MARS-UVA/Jetson_Extension_Board/LTST_C191KGKT/LTST-C191KGKT.step

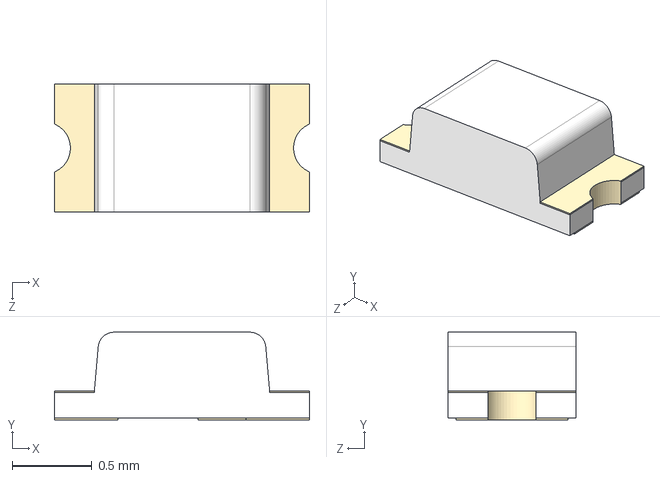
[picture p1: CAD file, 2024-10-27]
LTST_C191KGKT/LTST-C191KGKT.step
1.60 x 0.55 x 0.8 mm
