MARS-UVA/Jetson_Extension_Board/RC0603FR_07150RL/RC0603FR-07150RL.step

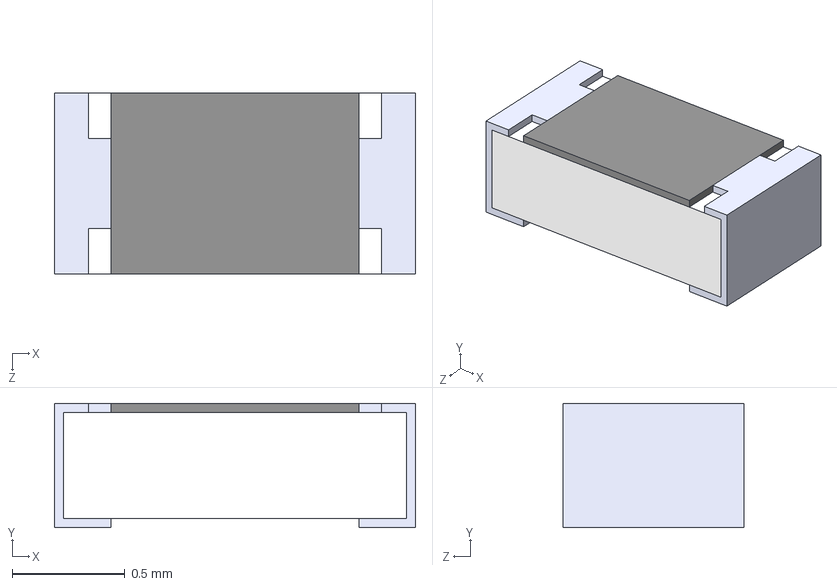
[picture p2: CAD file, 2024-10-27]
RC0603FR_07150RL/RC0603FR-07150RL.step
1.60 x 0.55 x 0.8 mm
