MARS-UVA/Jetson_Extension_Board/Jetson_Extension_Board.kicad_pcb

## KiCad design Jetson_Extension_Board.kicad_pcb (2025-04-29)

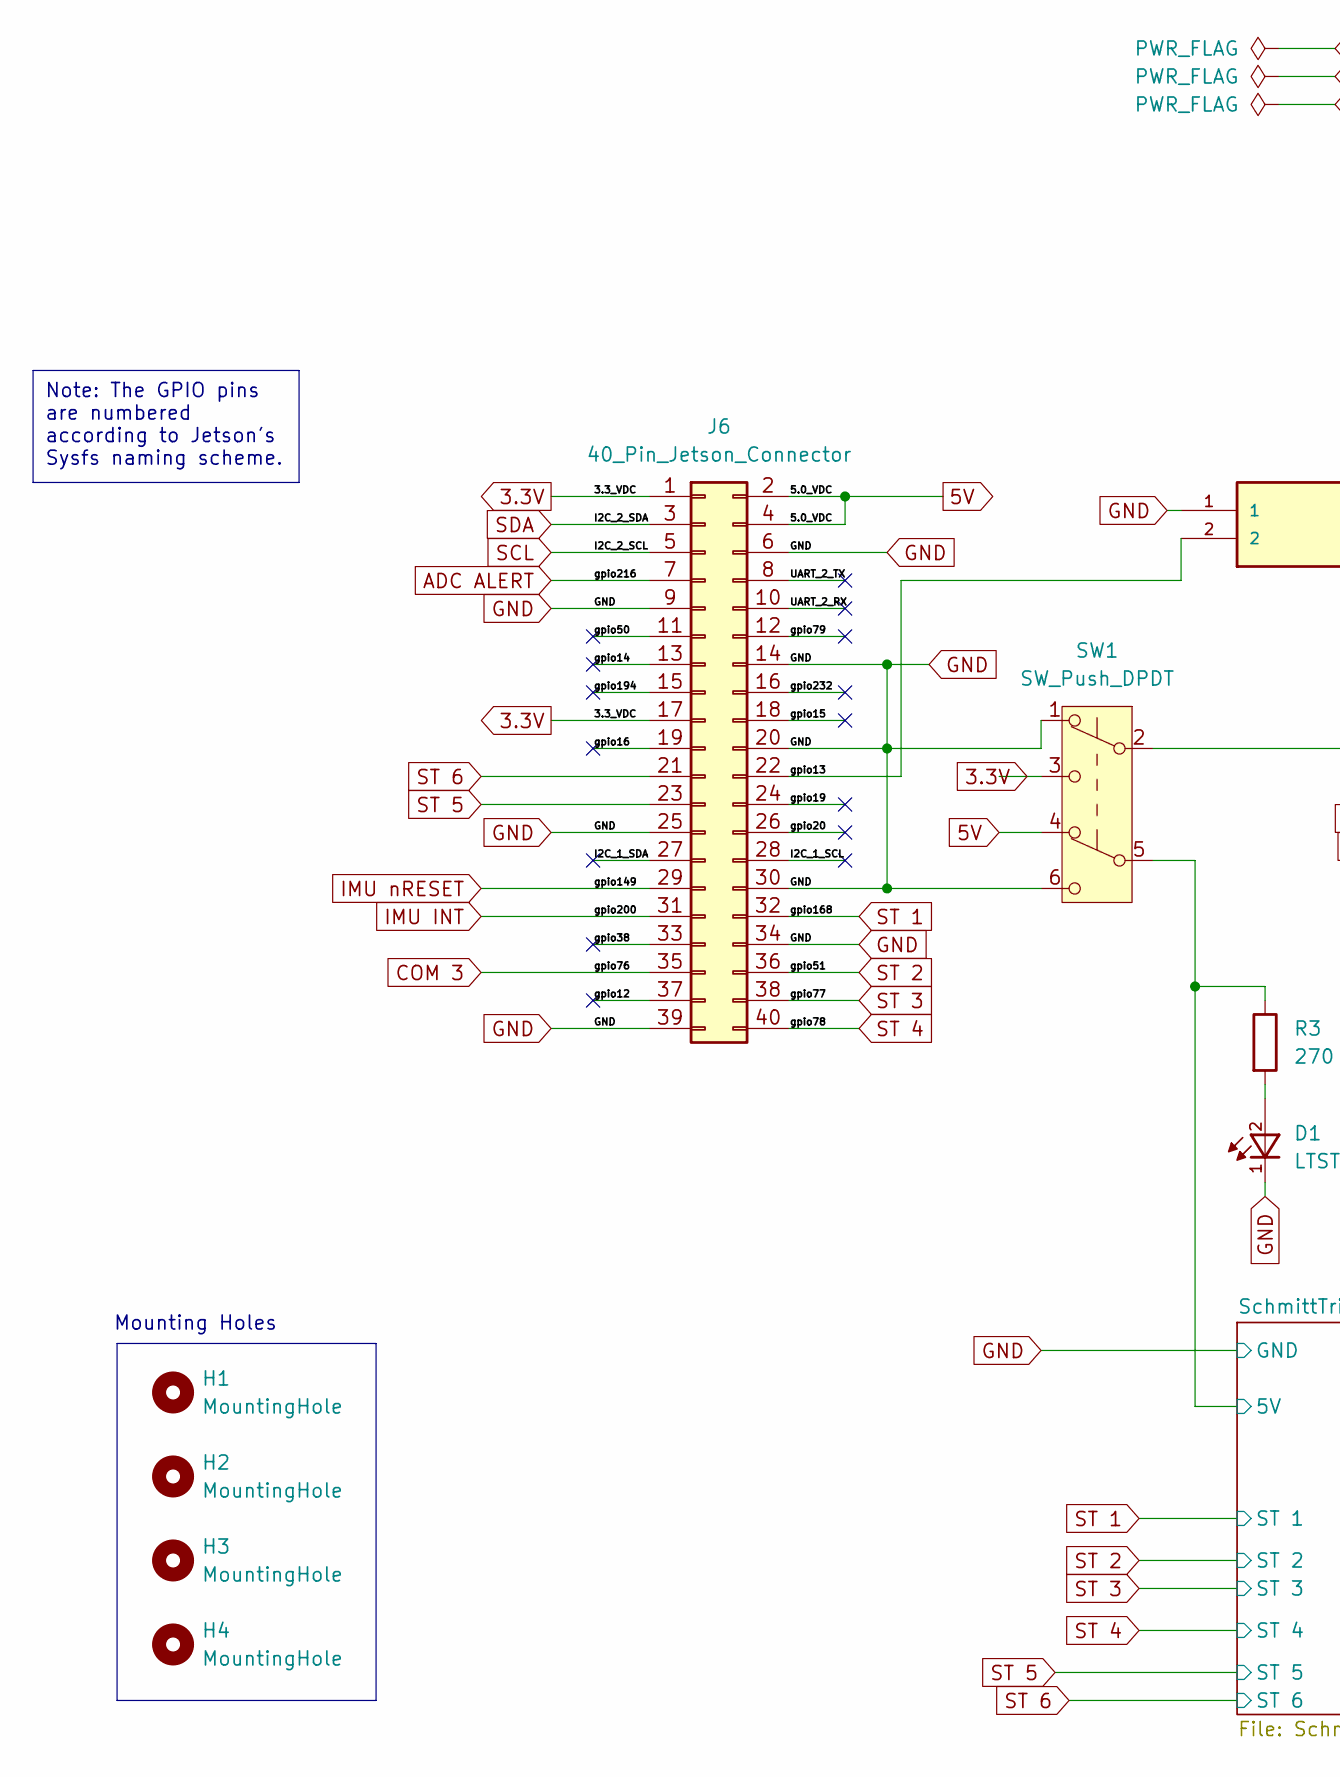
[picture p3: schematic Jetson_Extension_Board.kicad_sch, part in row 1, column 1]

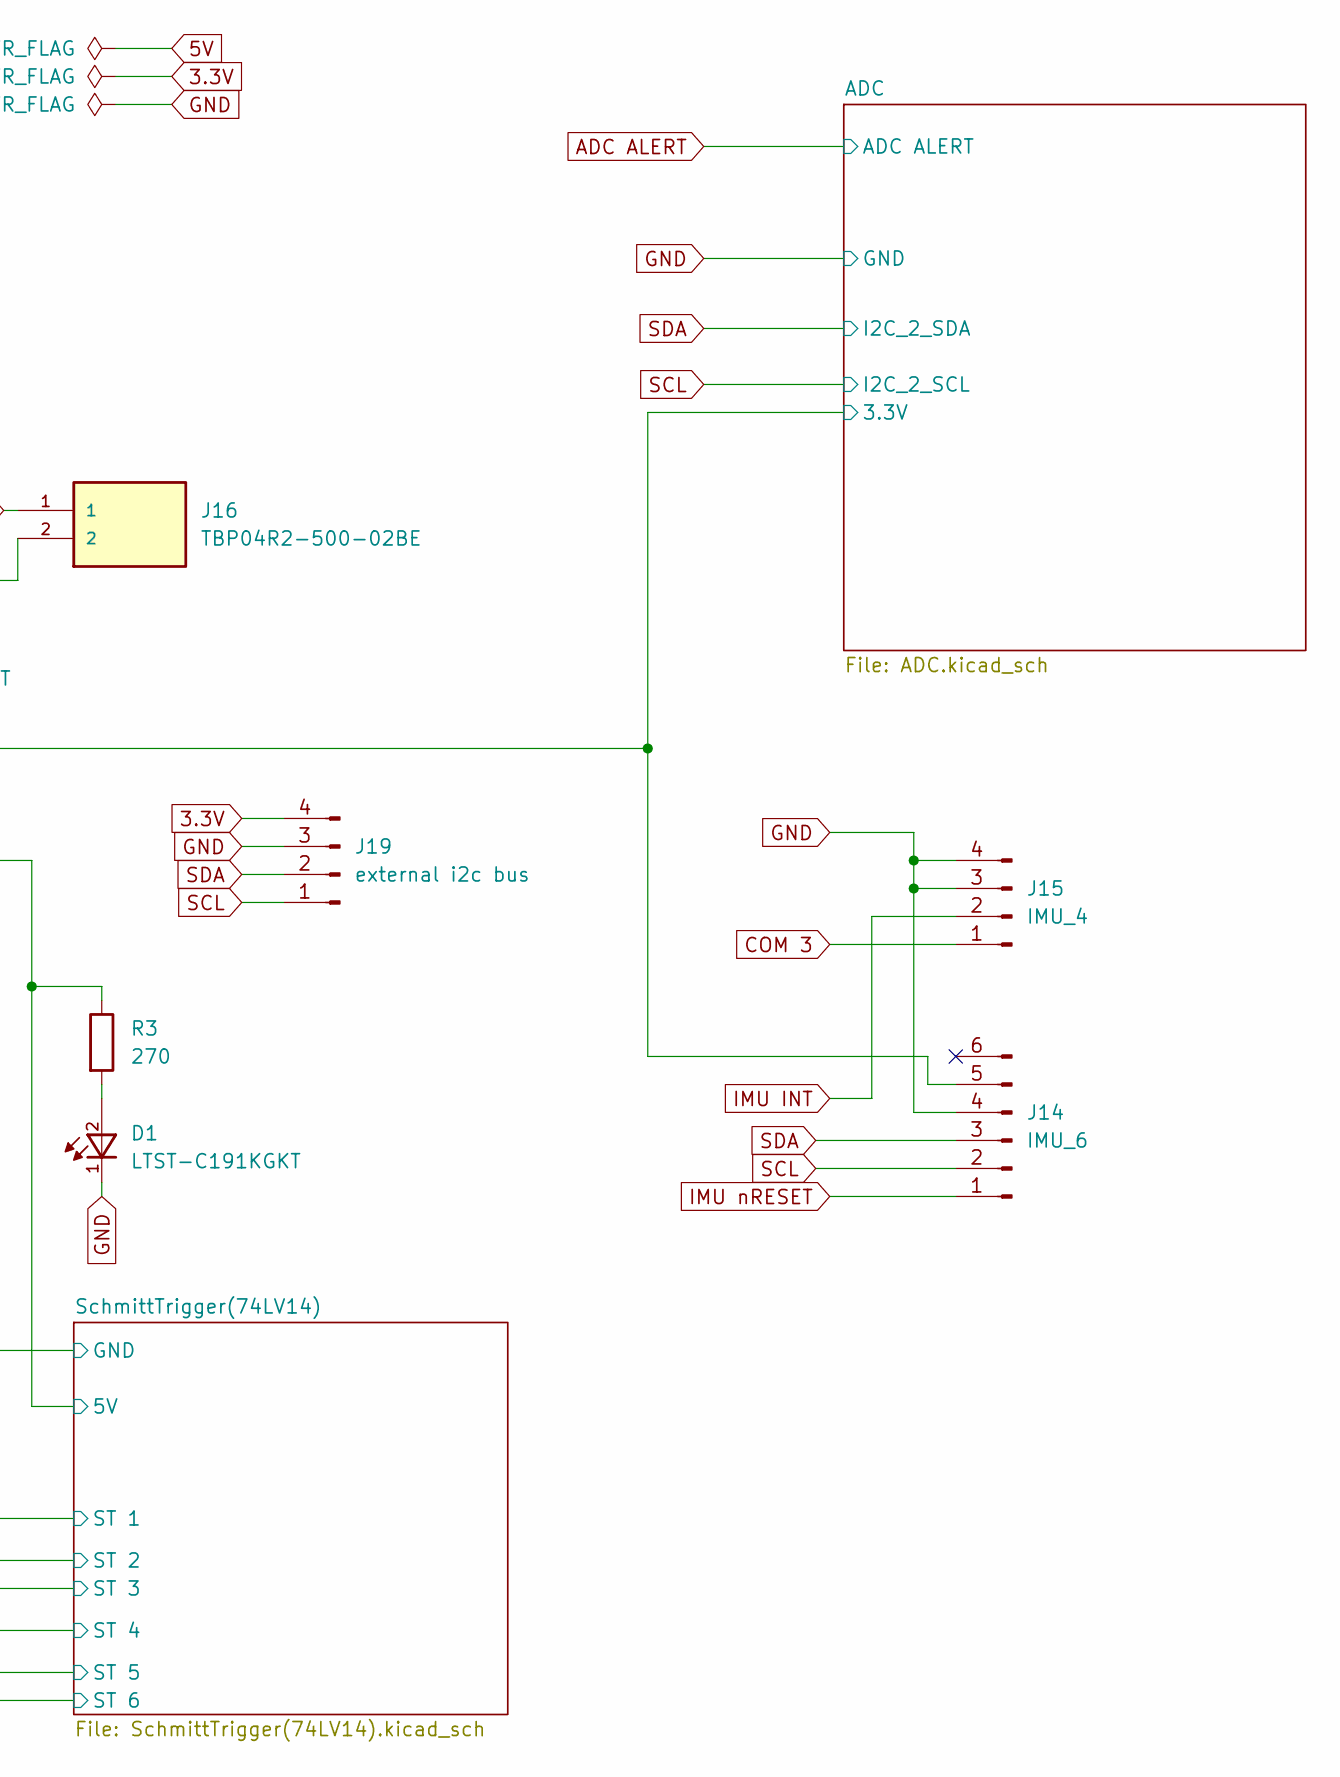
[picture p4: schematic Jetson_Extension_Board.kicad_sch, part in row 1, column 2]

Parts:
D1: LTST-C191KGKT; 0603
H1, H2, H3, H4: MountingHole; MountingHole_2.1mm
J6: 40_Pin_Jetson_Connector; PinHeader_2x20_P2.54mm_Vertical
J14: IMU_6; PinSocket_1x06_P2.54mm_Vertical
J15: IMU_4; PinSocket_1x04_P2.54mm_Vertical
J16: TBP04R2-500-02BE; CUI_TBP04R2-500-02BE; PARTREV 1.0
J19: external i2c bus; TBP04R2-500-04BE
R3: 270; R_1206_3216Metric
SW1: SW_Push_DPDT; SW_CK_JS202011AQN_DPDT_Angled

Connections:
3.3V: J6.1, J6.17, J19.4, SW1.3 (C)
5V: J6.2, J6.4, SW1.4 (A)
/ADC/3.3V: J14.5, SW1.2 (B); also elsewhere on the board
/I2C_1_SCL: J6.28
/I2C_1_SDA: J6.27
/SchmittTrigger(74LV14)/5V: R3.1, SW1.5 (B); also elsewhere on the board
/UART_2_RX: J6.10
/UART_2_TX: J6.8
/gpio12: J6.37
/gpio13: J6.22, J16.2; also elsewhere on the board
/gpio14: J6.13
/gpio15: J6.18
/gpio16: J6.19
/gpio19: J6.24
/gpio20: J6.26
/gpio38: J6.33
/gpio50: J6.11
/gpio79: J6.12
/gpio194: J6.15
/gpio232: J6.16
ADC ALERT: J6.7; also elsewhere on the board
COM 3: J6.35, J15.1
GND: D1.1, J6.6, J6.9, J6.14, J6.20, J6.25, J6.30, J6.34, J6.39, J14.4, J15.3, J15.4, J16.1, J19.3, SW1.1 (A), SW1.6 (C); also elsewhere on the board
IMU INT: J6.31, J15.2
IMU nRESET: J6.29, J14.1
unnamed: D1.2, R3.2
SCL: J6.5, J14.2, J19.1; also elsewhere on the board
SDA: J6.3, J14.3, J19.2; also elsewhere on the board
ST 1: J6.32; also elsewhere on the board
ST 2: J6.36; also elsewhere on the board
ST 3: J6.38; also elsewhere on the board
ST 4: J6.40; also elsewhere on the board
ST 5: J6.23; also elsewhere on the board
ST 6: J6.21; also elsewhere on the board

Notes on the sheet:
Note: The GPIO pins are numbered according to Jetson's Sysfs naming scheme.
Mounting Holes

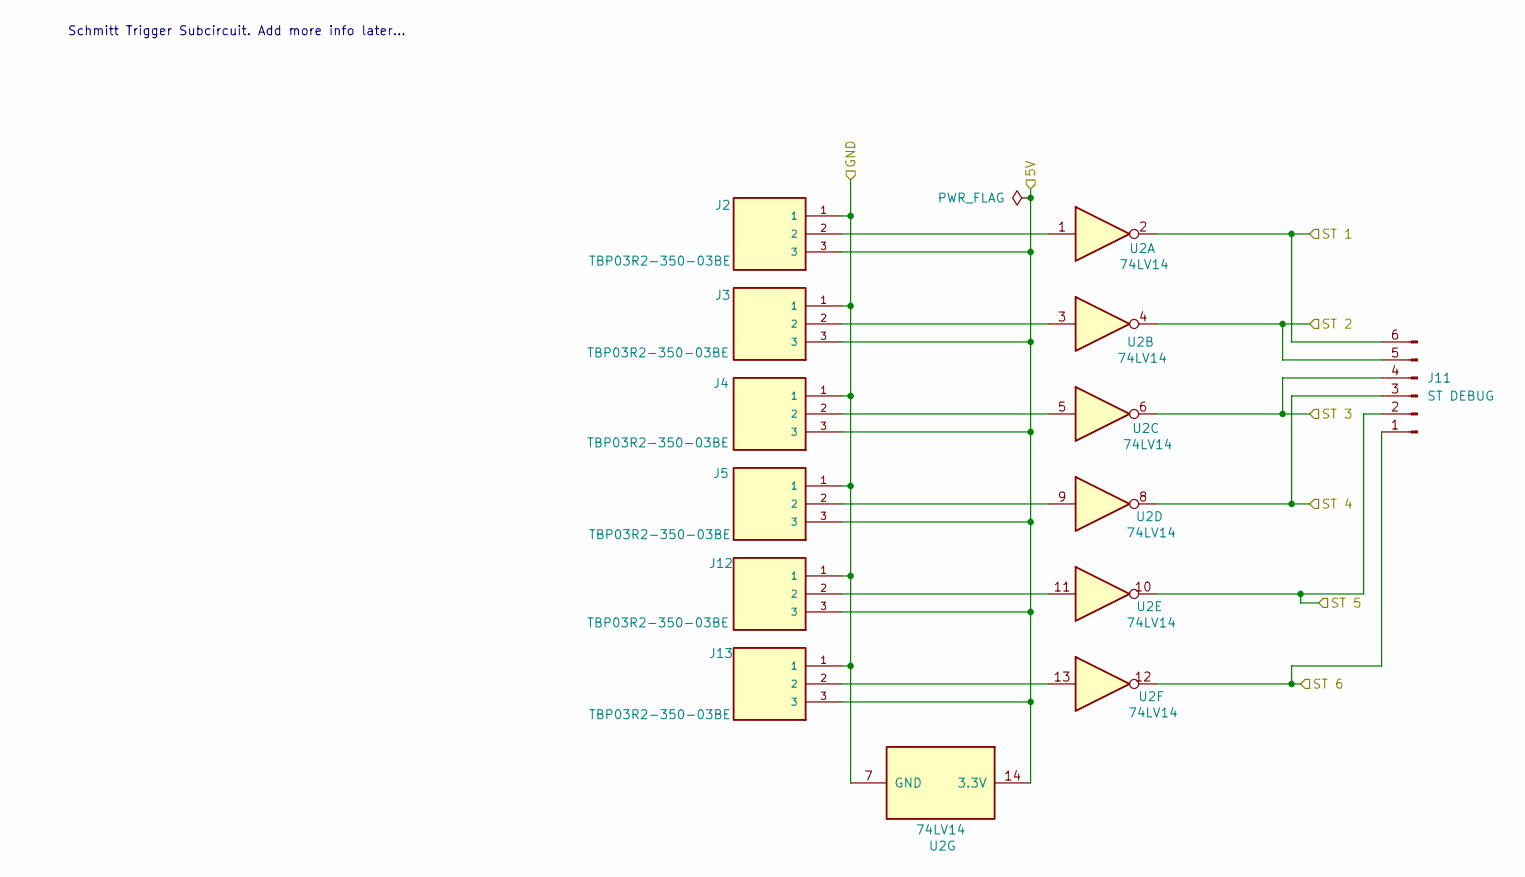
[picture p5: schematic SchmittTrigger(74LV14).kicad_sch]

Parts:
J2, J3, J4, J5, J12, J13: TBP03R2-350-03BE; CUI_TBP03R2-350-03BE; PARTREV 1.0
J11: ST DEBUG; PinSocket_1x06_P2.54mm_Vertical
U2: 74LV14; DIP-14_W7.62mm_Socket

Connections:
/SchmittTrigger(74LV14)/5V: J2.3, J3.3, J4.3, J5.3, J12.3, J13.3, U2.14 (3.3V); also elsewhere on the board
GND: J2.1, J3.1, J4.1, J5.1, J12.1, J13.1, U2.7 (GND); also elsewhere on the board
unnamed: J2.2, U2.1
unnamed: J3.2, U2.3
unnamed: J4.2, U2.5
unnamed: J5.2, U2.9
unnamed: J12.2, U2.11
unnamed: J13.2, U2.13
ST 1: J11.6, U2.2; also elsewhere on the board
ST 2: J11.5, U2.4; also elsewhere on the board
ST 3: J11.4, U2.6; also elsewhere on the board
ST 4: J11.3, U2.8; also elsewhere on the board
ST 5: J11.2, U2.10; also elsewhere on the board
ST 6: J11.1, U2.12; also elsewhere on the board

Notes on the sheet:
Schmitt Trigger Subcircuit. Add more info later...

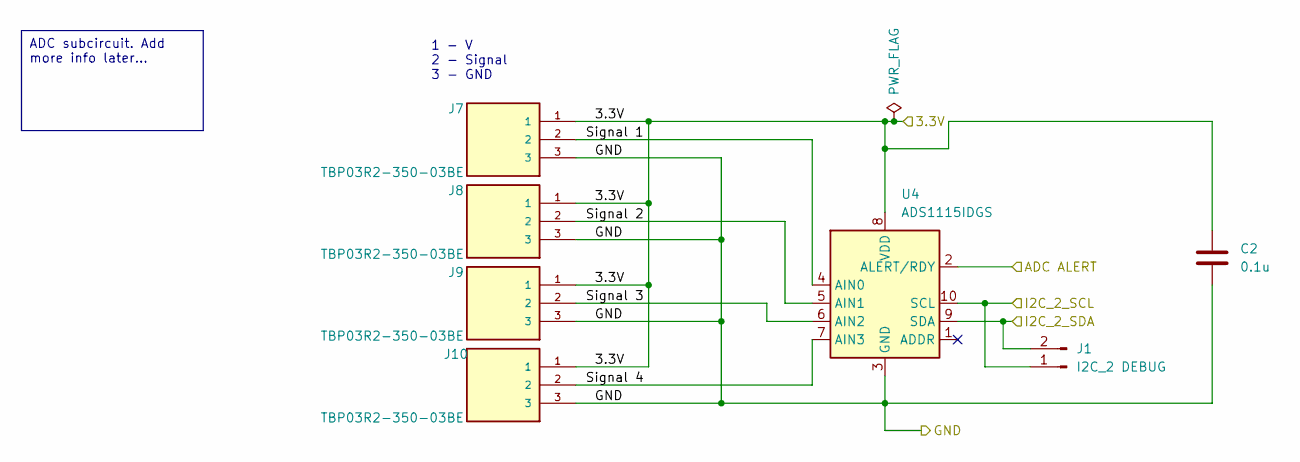
[picture p6: schematic ADC.kicad_sch]

Parts:
C2: 0.1u; C_1206_3216Metric
J1: I2C_2 DEBUG; PinSocket_1x02_P2.54mm_Vertical
J7, J8, J9, J10: TBP03R2-350-03BE; CUI_TBP03R2-350-03BE; PARTREV 1.0
U4: ADS1115IDGS; TSSOP-10_3x3mm_P0.5mm

Connections:
/ADC/3.3V: C2.1, J7.1, J8.1, J9.1, J10.1, U4.8 (VDD); also elsewhere on the board
/ADC/Signal 1: J7.2, U4.4 (AIN0)
/ADC/Signal 2: J8.2, U4.5 (AIN1)
/ADC/Signal 3: J9.2, U4.6 (AIN2)
/ADC/Signal 4: J10.2, U4.7 (AIN3)
ADC ALERT: U4.2 (ALERT/RDY); also elsewhere on the board
GND: C2.2, J7.3, J8.3, J9.3, J10.3, U4.3 (GND); also elsewhere on the board
SCL: J1.1, U4.10 (SCL); also elsewhere on the board
SDA: J1.2, U4.9 (SDA); also elsewhere on the board

Notes on the sheet:
ADC subcircuit. Add more info later...
1 - V 2 - Signal 3 - GND

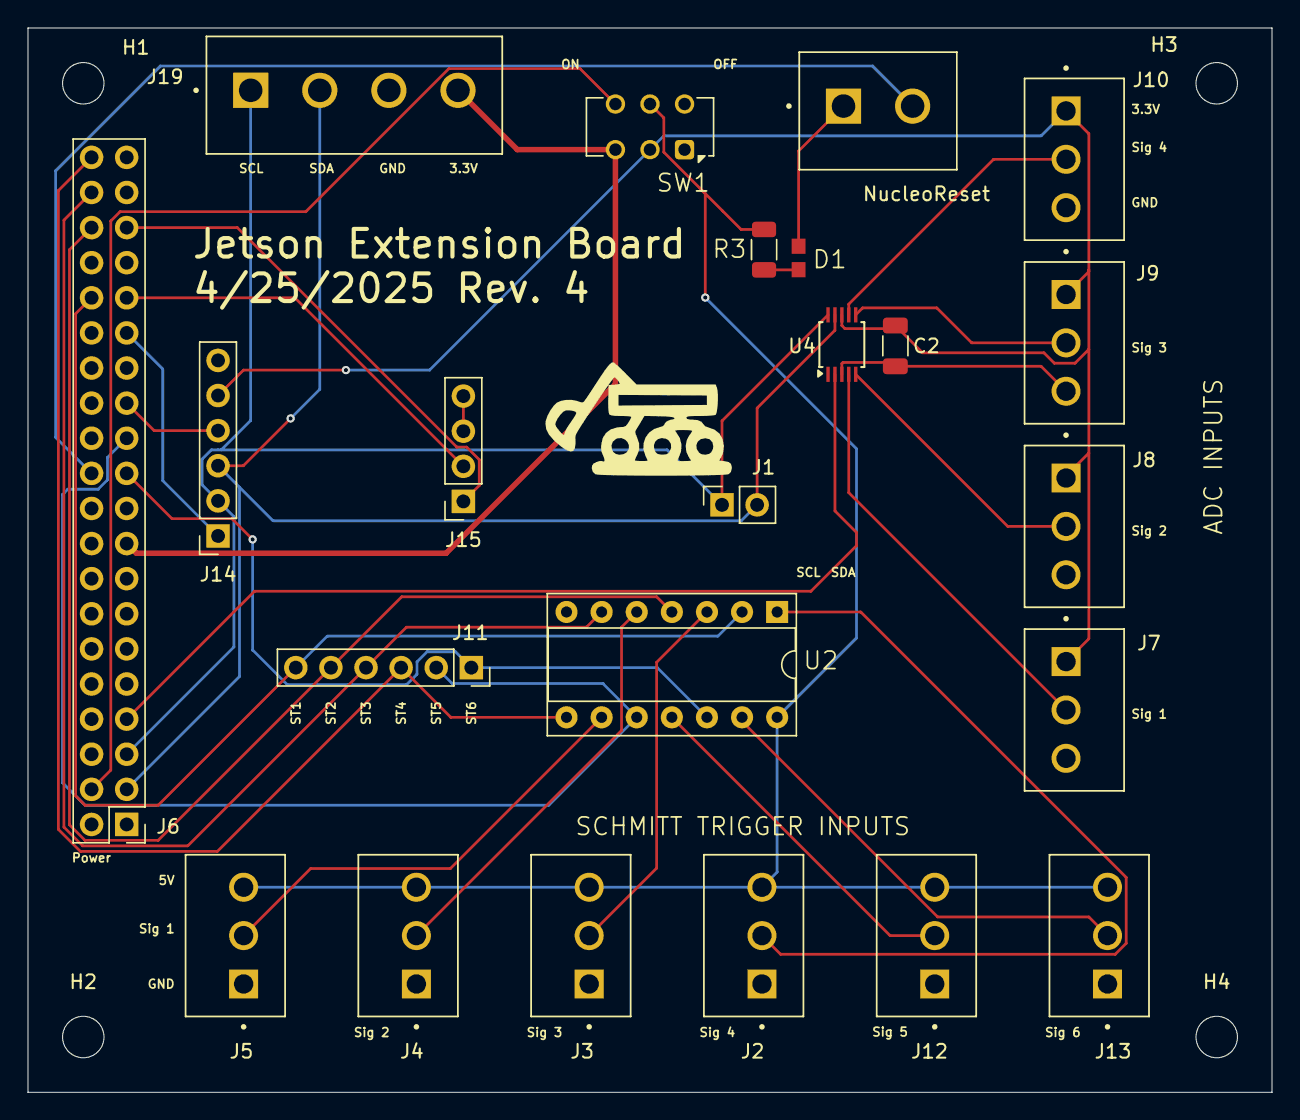
[picture p7: board Jetson_Extension_Board.kicad_pcb from above]

Board: 2 copper layers, 90.0 x 77.0 mm, 27 parts (0 on the bottom side), 29 nets.

Other parts of the board:
NucleoReset: TBP04R2-500-02BE; CUI_TBP04R2-500-02BE

Their connections:
/gpio13: NucleoReset.2; also elsewhere on the board
GND: NucleoReset.1; also elsewhere on the board
