MARS-UVA/Jetson_Extension_Board/(commit log)

2024-10-06 Version 2 of ADS1115 Subcircuit
    Change power voltage to 3.3V and added 100 nF decoupling capacitor
    [Ads1115 subcircuit.kicad_sch]
2024-10-06 Schmitt Trigger Subcircuit
    [Schmitt Trigger Subcircuit.kicad_sch]
2024-10-08 Whole Circuit Integration
    [ADC.kicad_sch, IMU(BN0055).kicad_sch, SchmittTrigger(74LV14).kicad_sch, WholeCircuitIntegration(Flagged).kicad_sch]
2024-10-09 Replaced sockets with terminal blocks
    [ADC.kicad_sch, WholeCircuitIntegration(Flagged).kicad_sch]
2024-10-11 Reorganized schematic and resolved ERC errors
    Resolved some of the ERC errors related to disconnected pins and power flags. Renamed GPIO pins on 40-pin header. Changed ADC power supply to 3.3V and schmitt trigger circuit power supply to 5V. Connected 5V, 3.3V, and GND pins of 40-pin header. Assigned footprint for 40-pin header based on dimensions of expansion header on Jetson Nano Carrier Board.
    Also moved IMU and 40-pin header KiCAD project files into their own folders.
    [ADC.kicad_sch, IMU(BN0055).kicad_sch, IMU_thingy.kicad_sch, SchmittTrigger(74LV14).kicad_sch, WholeCircuitIntegration(Flagged).kicad_sch]
2024-10-11 Renamed the project file to Jetson_Extension_Board
    [Jetson_Extension_Board.kicad_sch]
2024-10-11 Added Layout file
    [Jetson_Extension_Board.kicad_pcb]
2024-10-11 PCB Layout attempted 1
    [Jetson_Extension_Board2.5.1.kicad_pcb, Jetson_Extension_Board2.5.kicad_pcb]
2024-10-18 Worked on PCB Layout
    [Jetson_Extension_Board.kicad_pcb]
2024-10-20 Deleted some extra files
    Deleted Jetson_Extension_Board2.5 and Jetson_Extension_Board2.5.1 Files
    [Jetson_Extension_Board2.5.1.kicad_pcb, Jetson_Extension_Board2.5.kicad_pcb]
2024-10-20 Add debug pins and switch
    [ADC.kicad_sch, Jetson_Extension_Board.kicad_sch, SchmittTrigger(74LV14).kicad_sch]
2024-10-20 Revert "Add debug pins and switch"
    [ADC.kicad_sch, Jetson_Extension_Board.kicad_sch, SchmittTrigger(74LV14).kicad_sch]
2024-10-20 Finished PCB Layout
    [Jetson_Extension_Board.kicad_pcb, Jetson_Extension_Board.kicad_sch]
2024-10-20 Created Gerber and Drill FIles
    [Jetson_Extension_Board-B_Cu.gbl, Jetson_Extension_Board-B_Mask.gbs, Jetson_Extension_Board-B_Silkscreen.gbo, Jetson_Extension_Board-Edge_Cuts.gm1, Jetson_Extension_Board-F_Cu.gtl, Jetson_Extension_Board-F_Mask.gts, Jetson_Extension_Board-F_Silkscreen.gto, Jetson_Extension_Board-NPTH.drl]
2024-10-22 debug pins schematic done and pcb partial
    [ADC.kicad_sch, Jetson_Extension_Board.kicad_pcb, Jetson_Extension_Board.kicad_sch, SchmittTrigger(74LV14).kicad_sch]
2024-10-27 Freerouted attempt
    [Jetson_Extension_Board(Pluh1).kicad_pcb, Jetson_Extension_Board(Pluh2).kicad_pcb, Jetson_Extension_Board.kicad_sch]
2024-10-27 More stuff yuh
    [Jetson_Extension_Board(Pluh2).kicad_pcb]
2024-10-27 (Pluh 2) is the current second revision
2024-10-27 Pluh 1 and 2 removed, main file is updated version
    [Jetson_Extension_Board(Pluh1).kicad_pcb, Jetson_Extension_Board(Pluh2).kicad_pcb, Jetson_Extension_Board.kicad_pcb, Jetson_Extension_Board.kicad_sch]
2024-10-27 LEDS
    consolidated file, added diode and resistor (look over), and silkscreen errors present
    [Jetson_Extension_Board.kicad_pcb, Jetson_Extension_Board.kicad_sch]
2024-10-27 Added Correct LED
    [Jetson_Extension_Board.kicad_pcb, Jetson_Extension_Board.kicad_sch, LTST-C191KGKT.step, RC0603FR-07150RL.step]
2024-10-27 Created New Gerber and Drill Files
    [Jetson_Extension_Board-B_Cu.gbl, Jetson_Extension_Board-B_Mask.gbs, Jetson_Extension_Board-B_Silkscreen.gbo, Jetson_Extension_Board-Edge_Cuts.gm1, Jetson_Extension_Board-F_Cu.gtl, Jetson_Extension_Board-F_Mask.gts, Jetson_Extension_Board-F_Silkscreen.gto, Jetson_Extension_Board-NPTH.drl]
2024-10-30 Edited silkscreen
    Added labels for debug pins
    [Jetson_Extension_Board-B_Cu.gbl, Jetson_Extension_Board-B_Mask.gbs, Jetson_Extension_Board-B_Silkscreen.gbo, Jetson_Extension_Board-Edge_Cuts.gm1, Jetson_Extension_Board-F_Cu.gtl, Jetson_Extension_Board-F_Mask.gts, Jetson_Extension_Board-F_Silkscreen.gto, Jetson_Extension_Board-job.gbrjob]
2024-11-02 Changed the resistor value of R3
    R3 is 270 ohms instead of 260 ohms.
    [Jetson_Extension_Board.kicad_sch]
2025-01-26 PCB Update
    [ADC.kicad_sch, Jetson_Extension_Board.kicad_pcb, Jetson_Extension_Board.kicad_sch, SchmittTrigger(74LV14).kicad_sch]
2025-01-29 added connectors for pots and compacted further
    [Jetson_Extension_Board.kicad_pcb, Jetson_Extension_Board.kicad_sch, SchmittTrigger(74LV14).kicad_sch]
2025-01-31 changed hole sizes, added labels, added ground plane, set trace width min
    [Jetson_Extension_Board.kicad_pcb, Jetson_Extension_Board.kicad_sch]
2025-02-02 alignment fixes
    [Jetson_Extension_Board.kicad_pcb]
2025-02-02 added i2c bus pins, fixed errors, is ready for a final review
    [Jetson_Extension_Board.kicad_pcb, Jetson_Extension_Board.kicad_sch, SchmittTrigger(74LV14).kicad_sch]
2025-02-05 made more fixes to JEB
    [Jetson_Extension_Board-B_Cu.gbl, Jetson_Extension_Board-B_Mask.gbs, Jetson_Extension_Board-B_Silkscreen.gbo, Jetson_Extension_Board-Edge_Cuts.gm1, Jetson_Extension_Board-F_Cu.gtl, Jetson_Extension_Board-F_Mask.gts, Jetson_Extension_Board-F_Silkscreen.gto, Jetson_Extension_Board-job.gbrjob]
2025-02-07 replaced pot blocks with a nucleo reset block
    [Jetson_Extension_Board.kicad_pcb, Jetson_Extension_Board.kicad_sch]
2025-02-07 fixed hole sizes
    [Jetson_Extension_Board.kicad_pcb]
2025-02-07 actually fixed holes this time
    [Jetson_Extension_Board.kicad_pcb]
2025-02-07 labels moved
    [Jetson_Extension_Board.kicad_pcb]
2025-02-25 Modified constraints and routing
    Set constraints according to JLCPCB specifications.
    [Jetson_Extension_Board.kicad_pcb]
2025-02-28 Generated Gerbers
    Also made slight modifications to routing and added board info to back silkscreen
    [Jetson_Extension_Board-B_Cu.gbl, Jetson_Extension_Board-B_Mask.gbs, Jetson_Extension_Board-B_Silkscreen.gbo, Jetson_Extension_Board-Edge_Cuts.gm1, Jetson_Extension_Board-F_Cu.gtl, Jetson_Extension_Board-F_Mask.gts, Jetson_Extension_Board-F_Silkscreen.gto, Jetson_Extension_Board-NPTH.drl]
2025-02-28 Generated front paste layer
    Added front paste layer to gerber files
    [Jetson_Extension_Board-B_Cu.gbl, Jetson_Extension_Board-B_Mask.gbs, Jetson_Extension_Board-B_Silkscreen.gbo, Jetson_Extension_Board-Edge_Cuts.gm1, Jetson_Extension_Board-F_Cu.gtl, Jetson_Extension_Board-F_Mask.gts, Jetson_Extension_Board-F_Paste.gtp, Jetson_Extension_Board-F_Silkscreen.gto]
2025-03-01 added front paste layer to gerber zip file
2025-04-25 v4 pcb
    drc: didn't connect 3.3v pins and 5v pins and some gnd pins are not connected to gnd plane; they are connected within the jetson, and I don't think it's necessary to connect them on the jeb. all components are connected to corresponding pins
    [Jetson_Extension_Board.kicad_pcb]
